MatteoTondelli/PureChess/README.md

# Pure Chess

## Overview
An Arduino-based chessboard that can interact with a _PureData_ patch.
