MatteoTondelli/PureChess/Hardware/Sensors/Sensors.kicad_pcb

## KiCad design Hardware/Sensors/Sensors.kicad_pcb (2022-09-03)

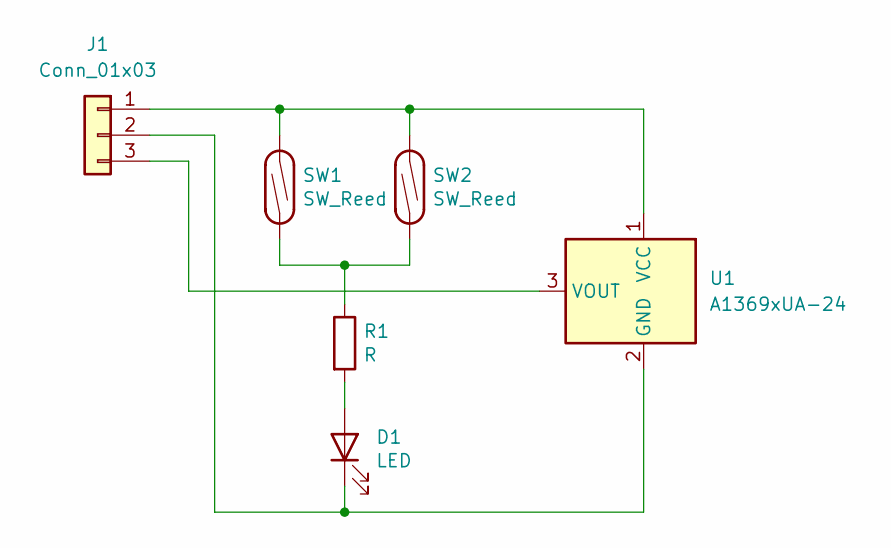
[picture p6: schematic Sensors.kicad_sch]

Parts:
D1: LED; LED_0805_2012Metric
J1: Conn_01x03; Pad_03x01
R1: R; R_0805_2012Metric
SW1, SW2: SW_Reed; ReedSwitch 2x14
U1: A1369xUA-24; SOT-23

Connections:
unnamed: D1.1 (K), J1.2, U1.2 (GND)
unnamed: D1.2 (A), R1.2
unnamed: J1.3, U1.3 (VOUT)
unnamed: R1.1, SW1.2, SW2.2
unnamed: J1.1, SW1.1, SW2.1, U1.1 (VCC)

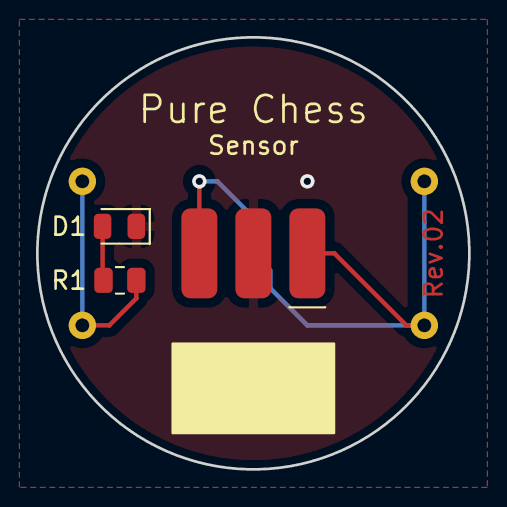
[picture p7: board Sensors.kicad_pcb from above]

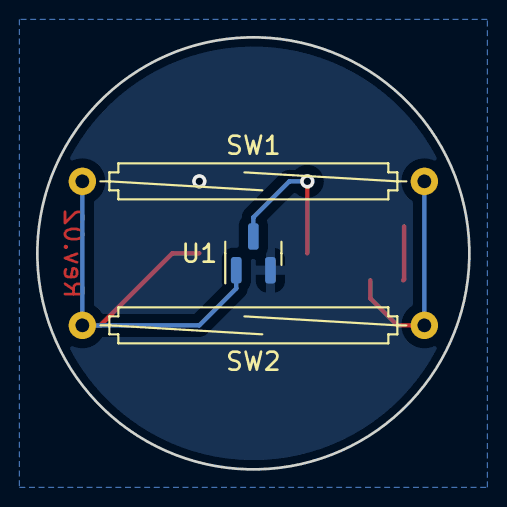
[picture p8: board Sensors.kicad_pcb from below]

Board: 2 copper layers, 24.0 x 24.0 mm, 6 parts (3 on the bottom side), 5 nets.
