MatteoTondelli/PureChess/Docs/how_to_build.rst

Making the Thing
================

So you want to build your own chessboard? Here's how!

Make sure to have all the necessary equipment and material.

List of Materials
-----------------

+---------------------+------+
| Item                | Q.ty |
+=====================+======+
| Chess board         | 1    |
+---------------------+------+
| Chess piece         | 32   |
+---------------------+------+
| Magnet              | 32   |
+---------------------+------+
| Arduino UNO R3      | 1    |
+---------------------+------+
| Reed switch         | 64   |
+---------------------+------+
| :doc:`sensor_board` | 64   |
+---------------------+------+
| :doc:`master_board` | 1    |
+---------------------+------+
