MatteoTondelli/PureChess/(commit log)

2022-02-06 Improved move detection algorithm.
    - Arduino must send all the changes of the board, not only the final position.
2022-02-12 Working on GUI.
    - Created main window with chess board rendering.
    - Started adding some features (Arduino simulation, load game).
2022-03-18 First MIDI interaction between chessboard and PureData.
    - Added "MIDI" and "PatchElements" modules.
    - Improved MIDI output device selection.
    - Added mechanism to send MIDI when a new chess move occurs.
2022-04-16 Added "Sensors" schematic and PCB layout.
    [Sensors.kicad_pcb, Sensors.sch]
2022-04-21 Sensors Rev.01 sent to production.
    - Generated gerbers for Sensors PCB Rev.01.
    [Sensors-B_Cu.gbr, Sensors-B_Mask.gbr, Sensors-B_Paste.gbr, Sensors-B_SilkS.gbr, Sensors-Edge_Cuts.gbr, Sensors-F_Cu.gbr, Sensors-F_Mask.gbr, Sensors-F_Paste.gbr]
2022-09-03 New PCB.
    - Added hall effect sensor.
    - Increased distance for reed switch mount holes.
    - Cables for connections will be soldered on pads instead of PTH.
    [Sensors-B_Cu.gbr, Sensors-B_Mask.gbr, Sensors-B_Paste.gbr, Sensors-B_SilkS.gbr, Sensors-B_Silkscreen.gbr, Sensors-Edge_Cuts.gbr, Sensors-F_Cu.gbr, Sensors-F_Mask.gbr]
2022-11-12 Created SerialCommunication.py
    - Created module to handle serial communication with Arduino.
2022-11-12 Updated documentation.
    - Added sensor board information.
    - Fixed few typos.
